madziarastanislaw/Woltomierz-Cyfrowy/docs/Sprawozdanie_Madziara_Wiszniowski.pdf

## Sprawozdanie

# Woltomierz Cyfrowy

## Stanisław Madziara

## Rafał Wiszniowski

1) Wprowadzenie

Celem projektu jest zbudowanie woltomierza cyfrowego. Sygnał pobierany ze źródła napięcia w zakresie 0 – 3.3 V przetwarzany jest przez moduł ADC pmod AD1 na 12 bitową wartość którą przekazuje do płytki FPGA ZedBoard Zynq-7000. Wartość ta jest zapisywana przez rejestr przesuwny, przetwarzana przez transkoder na wartość cyfrową, która przez moduł FTDI UART jest przekazywana do nadrzędnego komputera. Wartość jest wyświetlana w konsoli po uruchomieniu i interakcji z programem. Dodatkowo 8 najstarszych znaczących bitów jest wyświetlana na wbudowanych diodach LED płytki FPGA.

2) Opis funkcjonalny i konstrukcyjny

Zbudowany został woltomierz cyfrowy oparty na FPGA ( ZedBoard ) oraz module ADC ( Pmod-AD1 ).

Główne cechy funkcjonalne i konstrukcyjne:

- Całość logiki sterującej została zaimplementowana w języku SystemVerilog. Funkcję resetu pełni przycisk BTNC - środkowy przycisk na płytce.
- Pomiar napięcia odbywa się za pomocą modułu Pmod-AD1 wyposażonego w 12-bitowy przetwornik ADC. Urządzenie obsługuje pomiar napięcia w zakresie 0 - 3.3V.
- Dane z przetwornika są przeliczane w module transkodera na wartość napięcia, a następnie zamieniane na format ASCII - wzorzec “x.xxx”.
- Przez UART przesyłane są sformatowane wyniki pomiarów w czasie rzeczywistym do komputera.
- Diody LED na płytce ZedBoard wizualizują 8 najstarszych bitów aktualnego wyniku pomiaru napięcia.
- Projekt został podzielony na moduły ( SPI, transkoder, UART ), co umożliwiło nam nieżelazne testowanie każdego etapu i ułatwiło wykrywanie błędów.

3) Instrukcja uruchamiania urządzenia

### 1. Podłączenie sprzętu:

- Moduł Pmod-AD1 - należy wpiąć do złącza Pmod JA:
- JA1 - sygnał Chip Select,
- JA2 - sygnał MISO,
- JA4 - sygnał SCLK
- Konwerter USB-UART FTDI FT232 - należy wpiąć do złącza Pmod JD ( pin JD2_N - sygnał TX )

### 2. Programowanie FPGA:

- Otworzyć projekt w Vivado, uruchomić syntezę
- Uruchomić implementację i wygenerować bitstream
- Załadować wygenerowany bitstream do układu FPGA
- Po załadowaniu bitstreama diody LD0 - LD7 zaczną wskazywać binarną wartość napięcia
- Można nacisnąć przycisk BTNC ( środkowy na płytce ), aby zresetować system.

### 3. Obsługa po stronie PC:

- Zainstalować biblioteki do Pythona ( pyserial, matplotlib, pynput ): pip install pyserial matplotlib pynput
- Uruchomić skrypt:
python3 uart_project.py
- Wybrać odpowiedni port COM/ttyUSB
- Obsługa programu:
- Spacja - zapisuje aktualny pomiar i wyświetla go w konsoli
- q - kończy pracę programu i zapisuje dane do voltage.json
4) Implementacja i konstrukcja

### 1. Przeliczanie napięcia - transcoder

Z ADC odbierana jest 12-bitowa wartość ( Dout ), a natomiast napięcie referencyjne wynosi 3. 3 V = 3300 mV. Zgodnie z tymi danymi w pliku transcoder.sv obliczyliśmy wartość napięcia:

U =

Dout

* 3300

2

12 [ mV ]

Następnie tak uzyskany wynik w mV został rozbity na poszczególne cyfry ( za pomocą operatorów dzielenia i modulo ).

Tak otrzymane cyfry są zamieniane na ASCII poprzez dodanie prefiksu 4’h3.

### 2. Sender FSM

Automat stanów w sender.sv steruje wysyłką ramki danych. Kolejne stany w nim to:
- WAIT_TIME: oczekiwanie około 0.2s - pętla opóźniająca o 20 milionów taktów zegara 100MHz.
- SEND_ONE, SEND_DOT, SEND_DEC, SEND_CEN, SEND_MIL: sekwencyjne podawanie znaków na UART ( np. “3”, “.”, “2”, “7”, “0” )
- SEND_CR, SEND_LF: wysyłanie znaków końca linii, zapewniające czytelniejsze wyświetlanie danych w terminalu ( “\r”, “\n” )

### 3. Uart FSM

Automat startów w uart_tx.sv odpowiada za transmisję bajtu danych do komputera. Kolejne stany w nim to:
- IDLE: stan spoczynku - linia TX utrzymuje stan wysoki i oczekuje na sygnał startu.
- START_BIT: wystawienie bitu startu ( stan niski ) na czas trwania jednego bitu, informuje to odbiornik o rozpoczęciu transmisji.
- DATA_BITS: | sekwencyjne | wystawienie | 8 | bitów | danych
( od najmłodszego bitu ), synchronicznie z prędkością transmisji ( 9600 bps )
- STOP_BIT: wystawienie bitu stopu ( stan wysoki ), sygnalizujące zakończenie przesyłanie i powrót modułu do stanu gotowości

### 4. Spi Master FSM

Automat stanów w spi_master.sv steruje komunikacją z przetwornikiem ADC. Kolejne stany w nim to:
- RESET: inicjalizacja sygnałów sterujących - ustawienie wysokiego stanu na linii CS oraz zegara SCLK w stan spoczynku.
- START: aktywacja przetwornika poprzez ustawienie niskiego stanu na linii CS
- READING: taktowanie linii SCLK - 16 cykli - i jednoczesne pobieranie danych z MISO do rejestru przesuwnego. Po odebraniu pełnej ramki sygnał CS wraca w stan wysoki, wynik jest zatrzaskiwany.

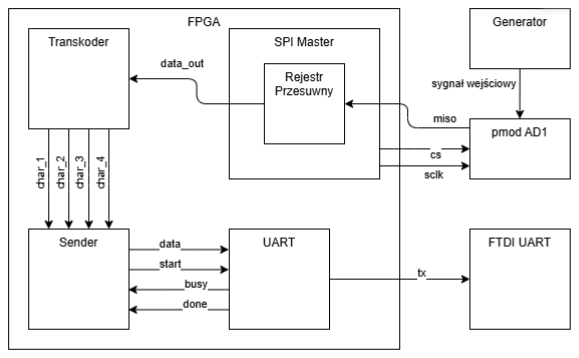
[picture p1: figure]

Schemat 1. - schemat blokowy urządzenia
5) Parametry techniczne i analiza zasobów

Parametry techniczne:

- Częstotliwość zegara - 100 Mhz
- Baud Rate dla UART - 9600 bps
- Format danych: 1 start bit, 8-bit data, 1 stop bit
- Opóźnienie przesyłania danych: 20,000,000 okresów zegara, około 0.2 s dla 100 MHz
- Częstotliwość “zegara” SPI - 20 MHz (na jeden okres sclk przypada 5 okresów clk)
- Dokładność pomiaru napięcia przez SPI - 0.8 mV

Analiza zasobów:

Lwia część zasobów jest wykorzystywana przez moduł transkodera, wykonująca kosztowne operacje dzielenia i modulo. Całość wykorzystuje 197 LUT, z czego 125 przypisane jest to tego właśnie modułu (ok. 63%). Wykorzystane jest 100 przerzutników w całej implementacji.

6) Wyniki i wnioski

Na podstawie pliku voltage.json, który wygenerowano na zajęciach wykonano analizę liniowości. Do pliku zostały zapisane pomiary w przedziale od 0.0 do 3.3V z krokiem 0.1 V. Można zauważyć, że na całym tym przedziale wartość odczytana jest bardzo zbliżona do wartości z zasilacza ( X ≈ Y ).

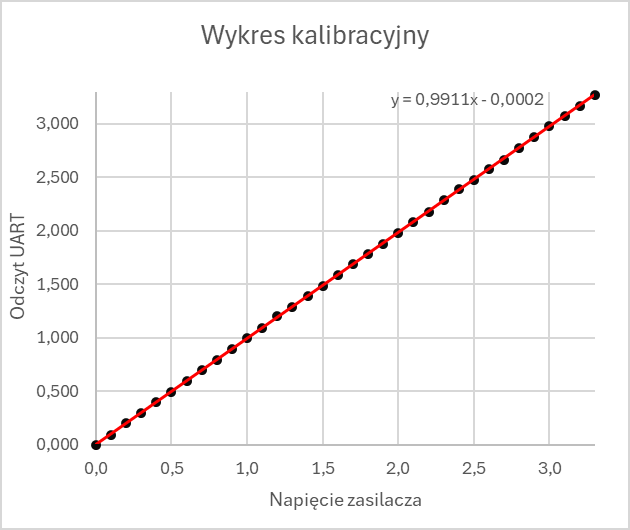
[picture p2: figure]

Rysunek 1. - regresja liniowa pomiarów

Na podstawie danych z pliku JSON wyznaczono funkcję kalibracyjną dla naszego woltomierza:

y = 0. 9911x − 0. 0002

Współczynnik kierunkowy bardzo bliski jedynce świadczy o dobrej liniowości woltomierza, a niemal zerowy wyraz wolny o braku znaczącego offsetu.

Niewielkie odchylenia przy wyższych napięciach mogą wynikać z tolerancji rezystorów w module Pmod-AD bądź dokładności napięcia referencyjnego na płytce ZedBoard ( 3.3V ).

Podsumowując, urządzenie pracuje stabilnie, poprawnie interpretuje dane z ADC i przesyła w formie ASCII. Dzięki temu mogliśmy przy użyciu skryptu w języku Python w łatwy sposób zapisać zmierzone dane do pliku JSON.
