madziarastanislaw/Woltomierz-Cyfrowy/constr/io.xdc

# ---------------------------------------------------------------------------- 
set_property PACKAGE_PIN Y9 [get_ports {clk}];  # "GCLK"
# ----------------------------------------------------------------------------
#set_property PACKAGE_PIN R16 [get_ports {rst}];  # "BTND"
set_property PACKAGE_PIN P16 [get_ports {rst}];  # "BTNC"
# ----------------------------------------------------------------------------

set_property PACKAGE_PIN T22 [get_ports {leds[0]}];  # "LD0"
set_property PACKAGE_PIN T21 [get_ports {leds[1]}];  # "LD1"
set_property PACKAGE_PIN U22 [get_ports {leds[2]}];  # "LD2"
set_property PACKAGE_PIN U21 [get_ports {leds[3]}];  # "LD3"
set_property PACKAGE_PIN V22 [get_ports {leds[4]}];  # "LD4"
set_property PACKAGE_PIN W22 [get_ports {leds[5]}];  # "LD5"
set_property PACKAGE_PIN U19 [get_ports {leds[6]}];  # "LD6"
set_property PACKAGE_PIN U14 [get_ports {leds[7]}];  # "LD7"

set_property PACKAGE_PIN Y11  [get_ports {cs}];  # "JA1"
set_property PACKAGE_PIN AA11 [get_ports {miso}];  # "JA2"
#set_property PACKAGE_PIN Y10  [get_ports {JA3}];  # "JA3"
set_property PACKAGE_PIN AA9  [get_ports {sclk}];  # "JA4"

set_property PACKAGE_PIN V5 [get_ports {uart_txd}];  # "JD2_N"



set_property IOSTANDARD LVCMOS33 [get_ports -of_objects [get_iobanks 33]];
set_property IOSTANDARD LVCMOS18 [get_ports -of_objects [get_iobanks 34]];
set_property IOSTANDARD LVCMOS33 [get_ports -of_objects [get_iobanks 13]];
set_property IOSTANDARD LVCMOS33 [get_ports {uart_txd}];
